Shadow220108/vex/BOM.csv

Item | Qty | Price ($) | Vendor
PCBA (2 boards) | 1 | 35.70 | JLCPCB
Total |  | 35.70
