Shadow220108/vex/production/bom.csv

Designator | Footprint | Quantity | Value | LCSC Part #
C1, C15, C16 | 1210 | 3 | 100uF
C10, C11, C14, C4, C6, C7, C8 | 0603 | 7 | 100nF
C12, C13 | 0603 | 2 | 18pF
C17, C18, C19, C20, C21, C22, C23 | 1206 | 7 | 47uF
C2, C3, C5, C9 | 0805 | 4 | 10uF
D1 | D_SMA | 1 | SMAJ5.0A
D2 | 0603 | 1 | Power-Blue
D3 | 0603 | 1 | Hub-Active Red
F1 | 1812 | 1 | 2A hold (1812)
F2 | 1812 | 1 | 1.5A hold (1812)
J1, J2, J3, J4 | USB_C_Receptacle_HRO_TYPE-C-31-M-12 | 4 | USB_C_Receptacle_USB2.0_16P
J5, J6, J7, J8 | USB_A_Molex_67643_Horizontal | 4 | USB_A
Q1, Q2, Q3 | SOT-23 | 3 | AO3401A
R1, R2 | 0603 | 2 | 5.1K
R10, R11, R12, R13, R14, R15 | 0603 | 6 | 56K
R3, R8 | 0603 | 2 | 1K
R4, R5 | 0603 | 2 | 100K
R6 | 0603 | 1 | 2.7K 1%
R7, R9 | 0603 | 2 | 10K
U1 | LQFP-48_L7.0-W7.0-P0.50-LS9.0-BL | 1 | FE2.1 | C39693
Y1 | Crystal_SMD_3225-4Pin_3.2x2.5mm | 1 | 12MHz
