Shadow220108/vex/docs/vex_zine.pdf

## I N T R O D U C I N G

# VEX

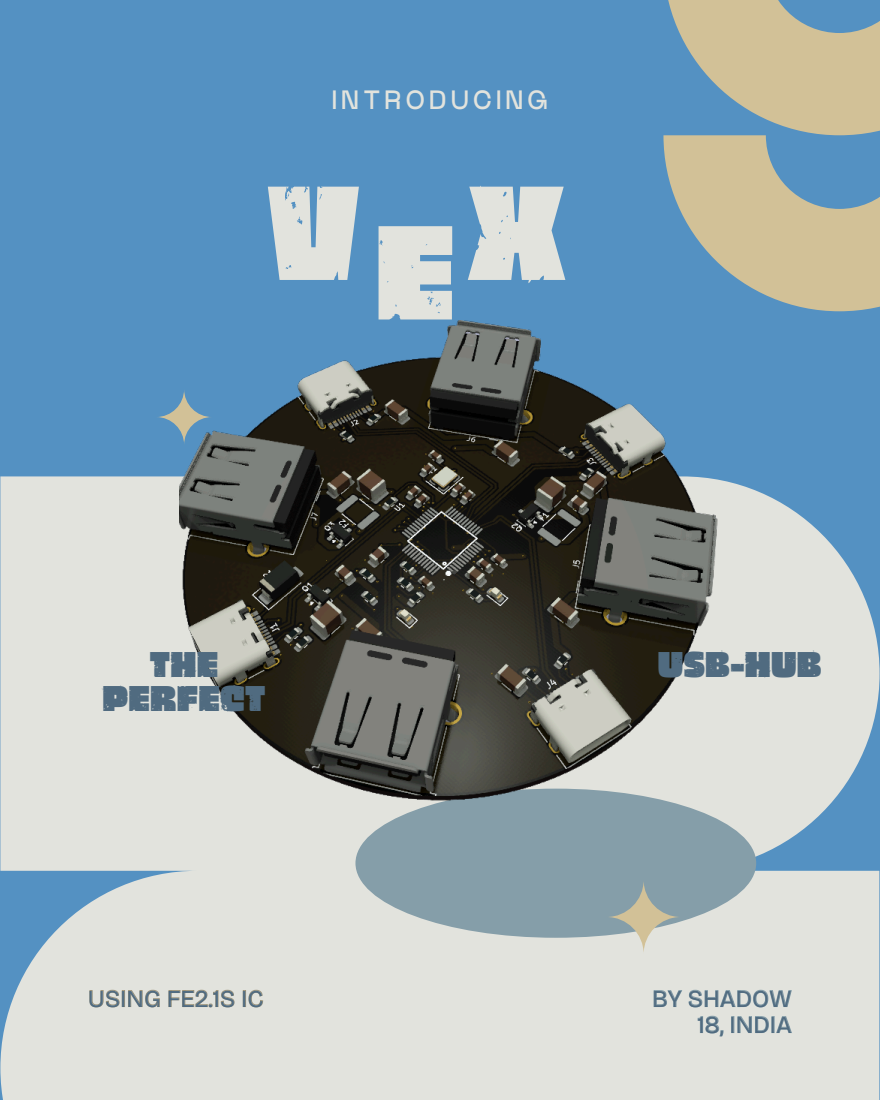
[picture p19: page 1]
THE PERFECT; USB-HUB; BY SHADOW 18, INDIA; USING FE2.1S IC
