Shadow220108/vex/PCB/vex.kicad_pcb

## KiCad design PCB/vex.kicad_pcb (2026-11-12)

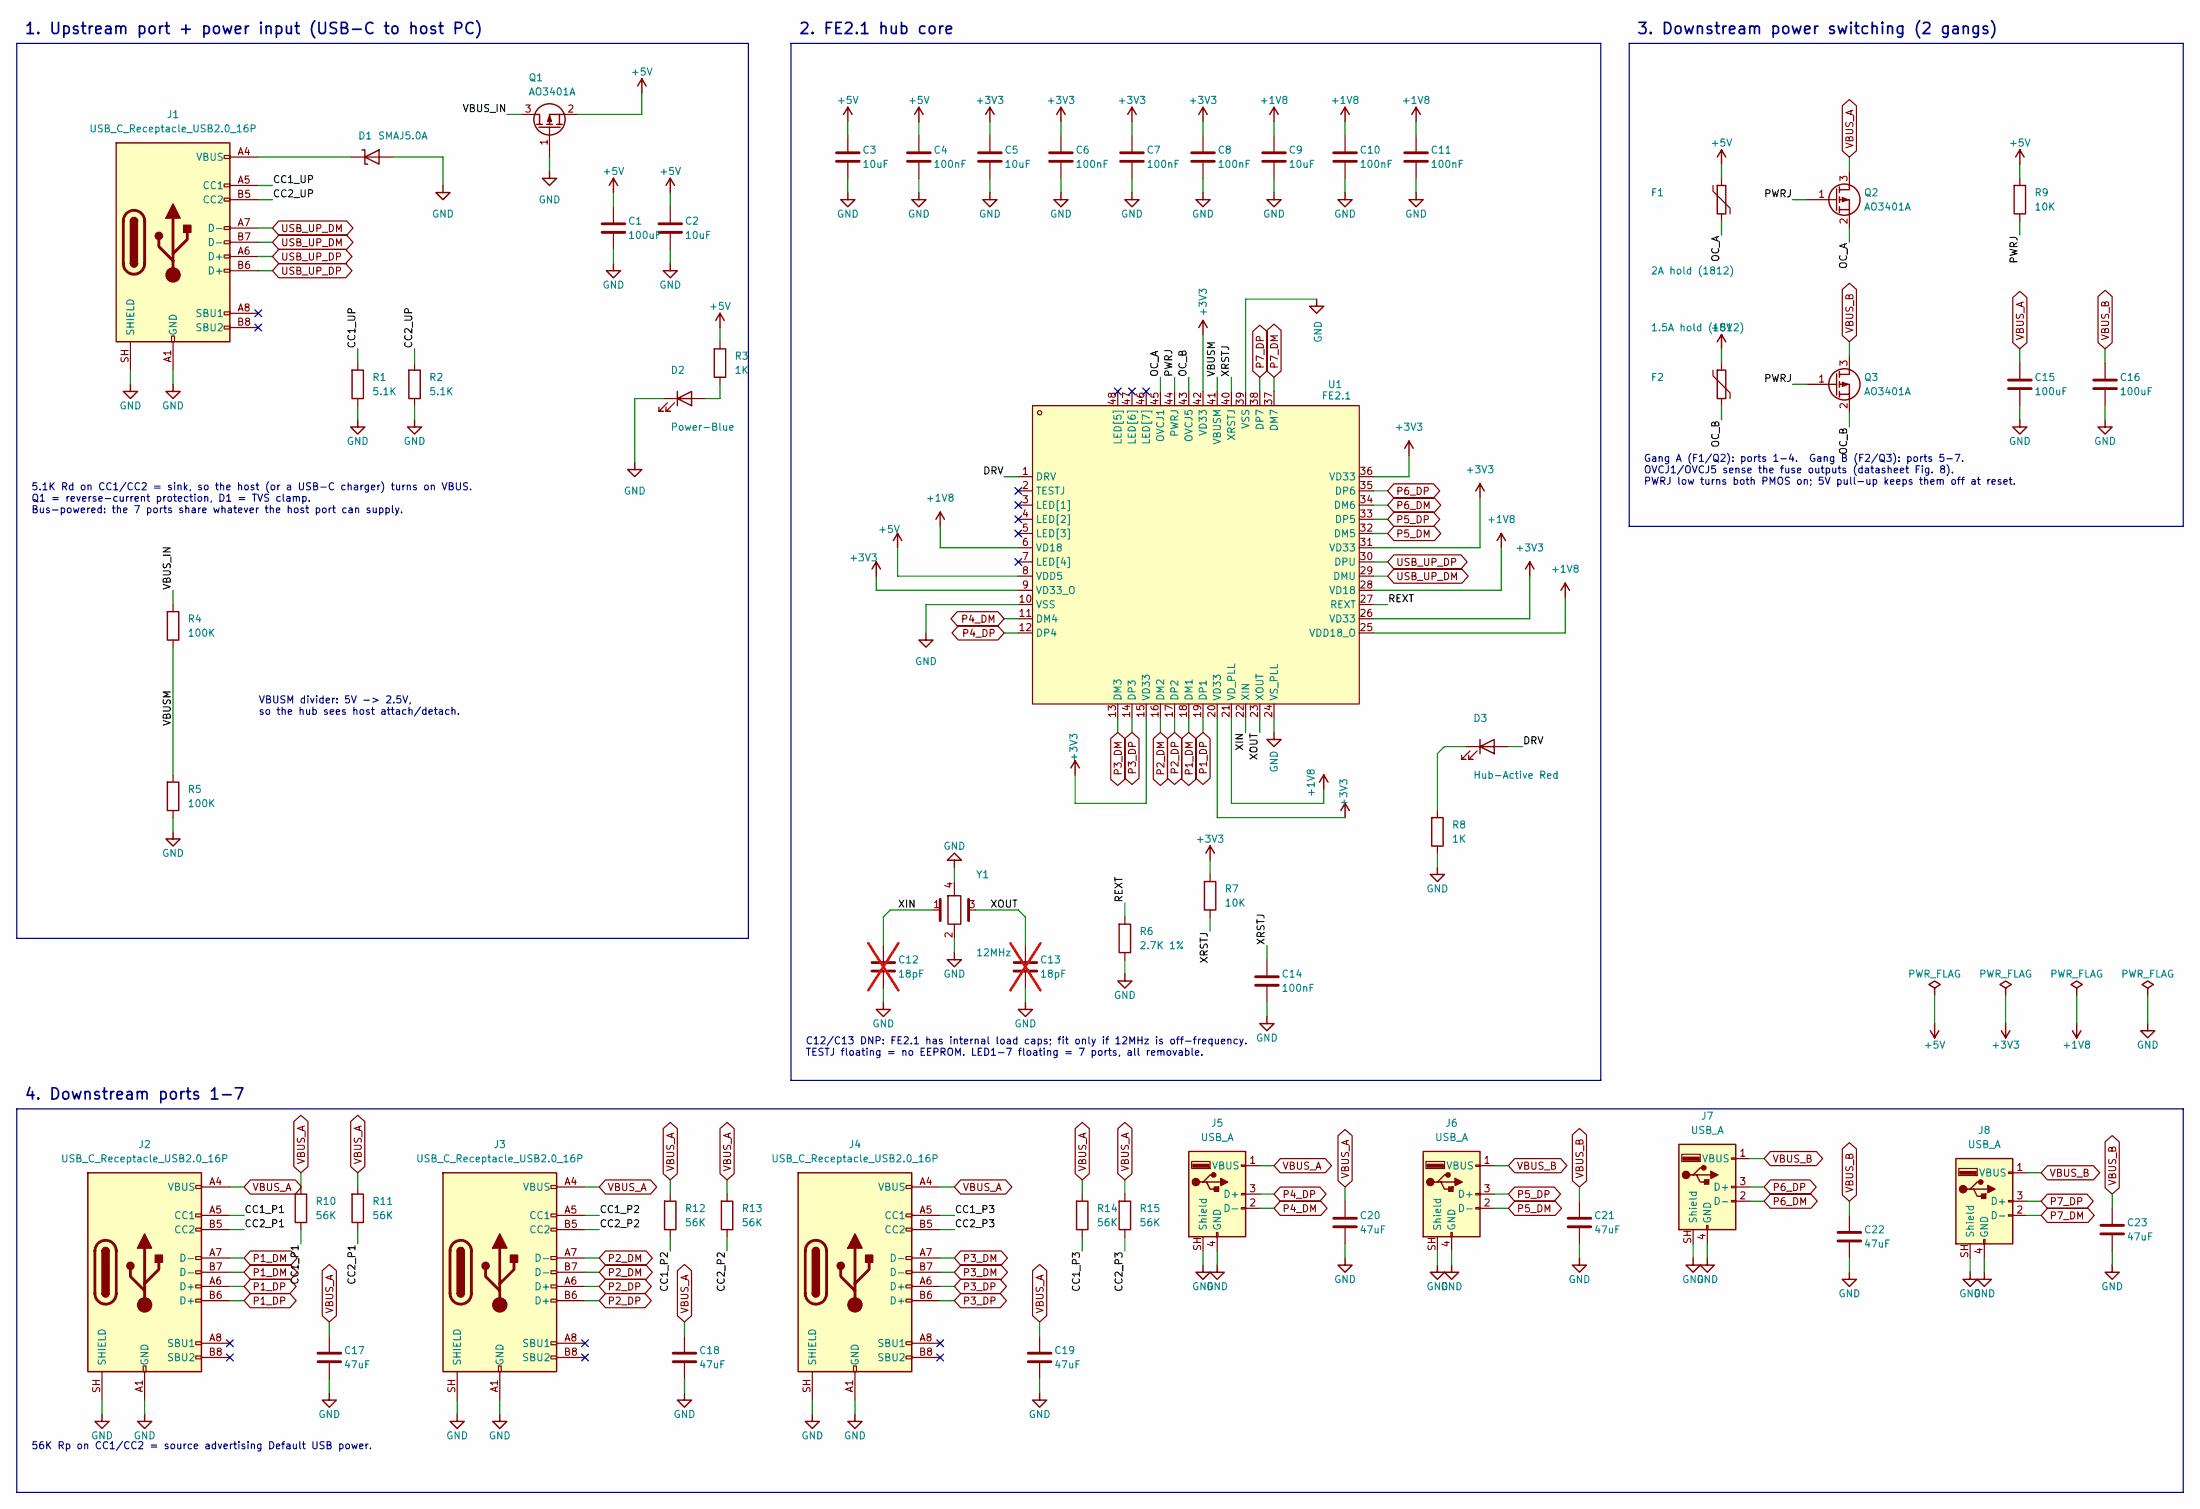
[picture p20: schematic vex.kicad_sch]

Parts:
C1, C15, C16: 100uF; C_1210_3225Metric
C2, C3, C5, C9: 10uF; C_0805_2012Metric
C4, C6, C7, C8, C10, C11, C14: 100nF; C_0603_1608Metric
C12, C13: 18pF; C_0603_1608Metric; not fitted
C17, C18, C19, C20, C21, C22, C23: 47uF; C_1206_3216Metric
D1: SMAJ5.0A; D_SMA
D2: Power-Blue; LED_0603_1608Metric
D3: Hub-Active Red; LED_0603_1608Metric
F1: 2A hold (1812); Fuse_1812_4532Metric
F2: 1.5A hold (1812); Fuse_1812_4532Metric
J1, J2, J3, J4: USB_C_Receptacle_USB2.0_16P; USB_C_Receptacle_HRO_TYPE-C-31-M-12
J5, J6, J7, J8: USB_A; USB_A_Molex_67643_Horizontal
Q1, Q2, Q3: AO3401A; SOT-23
R1, R2: 5.1K; R_0603_1608Metric
R3, R8: 1K; R_0603_1608Metric
R4, R5: 100K; R_0603_1608Metric
R6: 2.7K 1%; R_0603_1608Metric
R7, R9: 10K; R_0603_1608Metric
R10, R11, R12, R13, R14, R15: 56K; R_0603_1608Metric
U1: FE2.1; LQFP-48_L7.0-W7.0-P0.50-LS9.0-BL; MPN FE2.1-CQFP48A; LCSC Part C39693
Y1: 12MHz; Crystal_SMD_3225-4Pin_3.2x2.5mm

Connections:
+1V8: C9.1, C10.1, C11.1, U1.6 (VD18), U1.21 (VD_PLL), U1.25 (VDD18_O), U1.28 (VD18)
+3V3: C5.1, C6.1, C7.1, C8.1, R7.1, U1.9 (VD33_O), U1.15 (VD33), U1.20 (VD33), U1.26 (VD33), U1.31 (VD33), U1.36 (VD33), U1.42 (VD33)
+5V: C1.1, C2.1, C3.1, C4.1, F1.1, F2.1, Q1.2 (S), R3.1, R9.1, U1.8 (VDD5)
/CC1_P1: J2.A5 (CC1), R10.2
/CC1_P2: J3.A5 (CC1), R12.2
/CC1_P3: J4.A5 (CC1), R14.2
/CC1_UP: J1.A5 (CC1), R1.1
/CC2_P1: J2.B5 (CC2), R11.2
/CC2_P2: J3.B5 (CC2), R13.2
/CC2_P3: J4.B5 (CC2), R15.2
/CC2_UP: J1.B5 (CC2), R2.1
/DRV: D3.2 (A), U1.1 (DRV)
/OC_A: F1.2, Q2.2 (S), U1.45 (OVCJ1)
/OC_B: F2.2, Q3.2 (S), U1.43 (OVCJ5)
/PWRJ: Q2.1 (G), Q3.1 (G), R9.2, U1.44 (PWRJ)
/REXT: R6.1, U1.27 (REXT)
/VBUSM: R4.2, R5.1, U1.41 (VBUSM)
/VBUS_IN: Q1.3 (D), R4.1
/XIN: C12.1, U1.22 (XIN), Y1.1
/XOUT: C13.1, U1.23 (XOUT), Y1.3
/XRSTJ: C14.1, R7.2, U1.40 (XRSTJ)
GND: C1.2, C2.2, C3.2, C4.2, C5.2, C6.2, C7.2, C8.2, C9.2, C10.2, C11.2, C12.2, C13.2, C14.2, C15.2, C16.2, C17.2, C18.2, C19.2, C20.2, C21.2, C22.2, C23.2, D1.2 (A), D2.1 (K), J1.A1 (GND), J1.A12 (GND), J1.B1 (GND), J1.B12 (GND), J1.SH (SHIELD), J2.A1 (GND), J2.A12 (GND), J2.B1 (GND), J2.B12 (GND), J2.SH (SHIELD), J3.A1 (GND), J3.A12 (GND), J3.B1 (GND), J3.B12 (GND), J3.SH (SHIELD), J4.A1 (GND), J4.A12 (GND), J4.B1 (GND), J4.B12 (GND), J4.SH (SHIELD), J5.4 (GND), J5.SH (Shield), J6.4 (GND), J6.SH (Shield), J7.4 (GND), J7.SH (Shield), J8.4 (GND), J8.SH (Shield), Q1.1 (G), R1.2, R2.2, R5.2, R6.2, R8.2, U1.10 (VSS), U1.24 (VS_PLL), U1.39 (VSS), Y1.2, Y1.4
unnamed: D1.1 (K), J1.A4 (VBUS), J1.A9 (VBUS), J1.B4 (VBUS), J1.B9 (VBUS)
unnamed: D2.2 (A), R3.2
unnamed: D3.1 (K), R8.1
P1_DM: J2.A7 (D-), J2.B7 (D-), U1.18 (DM1)
P1_DP: J2.A6 (D+), J2.B6 (D+), U1.19 (DP1)
P2_DM: J3.A7 (D-), J3.B7 (D-), U1.16 (DM2)
P2_DP: J3.A6 (D+), J3.B6 (D+), U1.17 (DP2)
P3_DM: J4.A7 (D-), J4.B7 (D-), U1.13 (DM3)
P3_DP: J4.A6 (D+), J4.B6 (D+), U1.14 (DP3)
P4_DM: J5.2 (D-), U1.11 (DM4)
P4_DP: J5.3 (D+), U1.12 (DP4)
P5_DM: J6.2 (D-), U1.32 (DM5)
P5_DP: J6.3 (D+), U1.33 (DP5)
P6_DM: J7.2 (D-), U1.34 (DM6)
P6_DP: J7.3 (D+), U1.35 (DP6)
P7_DM: J8.2 (D-), U1.37 (DM7)
P7_DP: J8.3 (D+), U1.38 (DP7)
USB_UP_DM: J1.A7 (D-), J1.B7 (D-), U1.29 (DMU)
USB_UP_DP: J1.A6 (D+), J1.B6 (D+), U1.30 (DPU)
VBUS_A: C15.1, C17.1, C18.1, C19.1, C20.1, J2.A4 (VBUS), J2.A9 (VBUS), J2.B4 (VBUS), J2.B9 (VBUS), J3.A4 (VBUS), J3.A9 (VBUS), J3.B4 (VBUS), J3.B9 (VBUS), J4.A4 (VBUS), J4.A9 (VBUS), J4.B4 (VBUS), J4.B9 (VBUS), J5.1 (VBUS), Q2.3 (D), R10.1, R11.1, R12.1, R13.1, R14.1, R15.1
VBUS_B: C16.1, C21.1, C22.1, C23.1, J6.1 (VBUS), J7.1 (VBUS), J8.1 (VBUS), Q3.3 (D)

Notes on the sheet:
4. Downstream ports 1-7
C12/C13 DNP: FE2.1 has internal load caps; fit only if 12MHz is off-frequency. TESTJ floating = no EEPROM. LED1-7 floating = 7 ports, all removable.
VBUSM divider: 5V -> 2.5V, so the hub sees host attach/detach.
Gang A (F1/Q2): ports 1-4. Gang B (F2/Q3): ports 5-7. OVCJ1/OVCJ5 sense the fuse outputs (datasheet Fig. 8). PWRJ low turns both PMOS on; 5V pull-up keeps them off at reset.
1. Upstream port + power input (USB-C to host PC)
56K Rp on CC1/CC2 = source advertising Default USB power.
2. FE2.1 hub core
3. Downstream power switching (2 gangs)
5.1K Rd on CC1/CC2 = sink, so the host (or a USB-C charger) turns on VBUS. Q1 = reverse-current protection, D1 = TVS clamp. Bus-powered: the 7 ports share whatever the host port can supply.

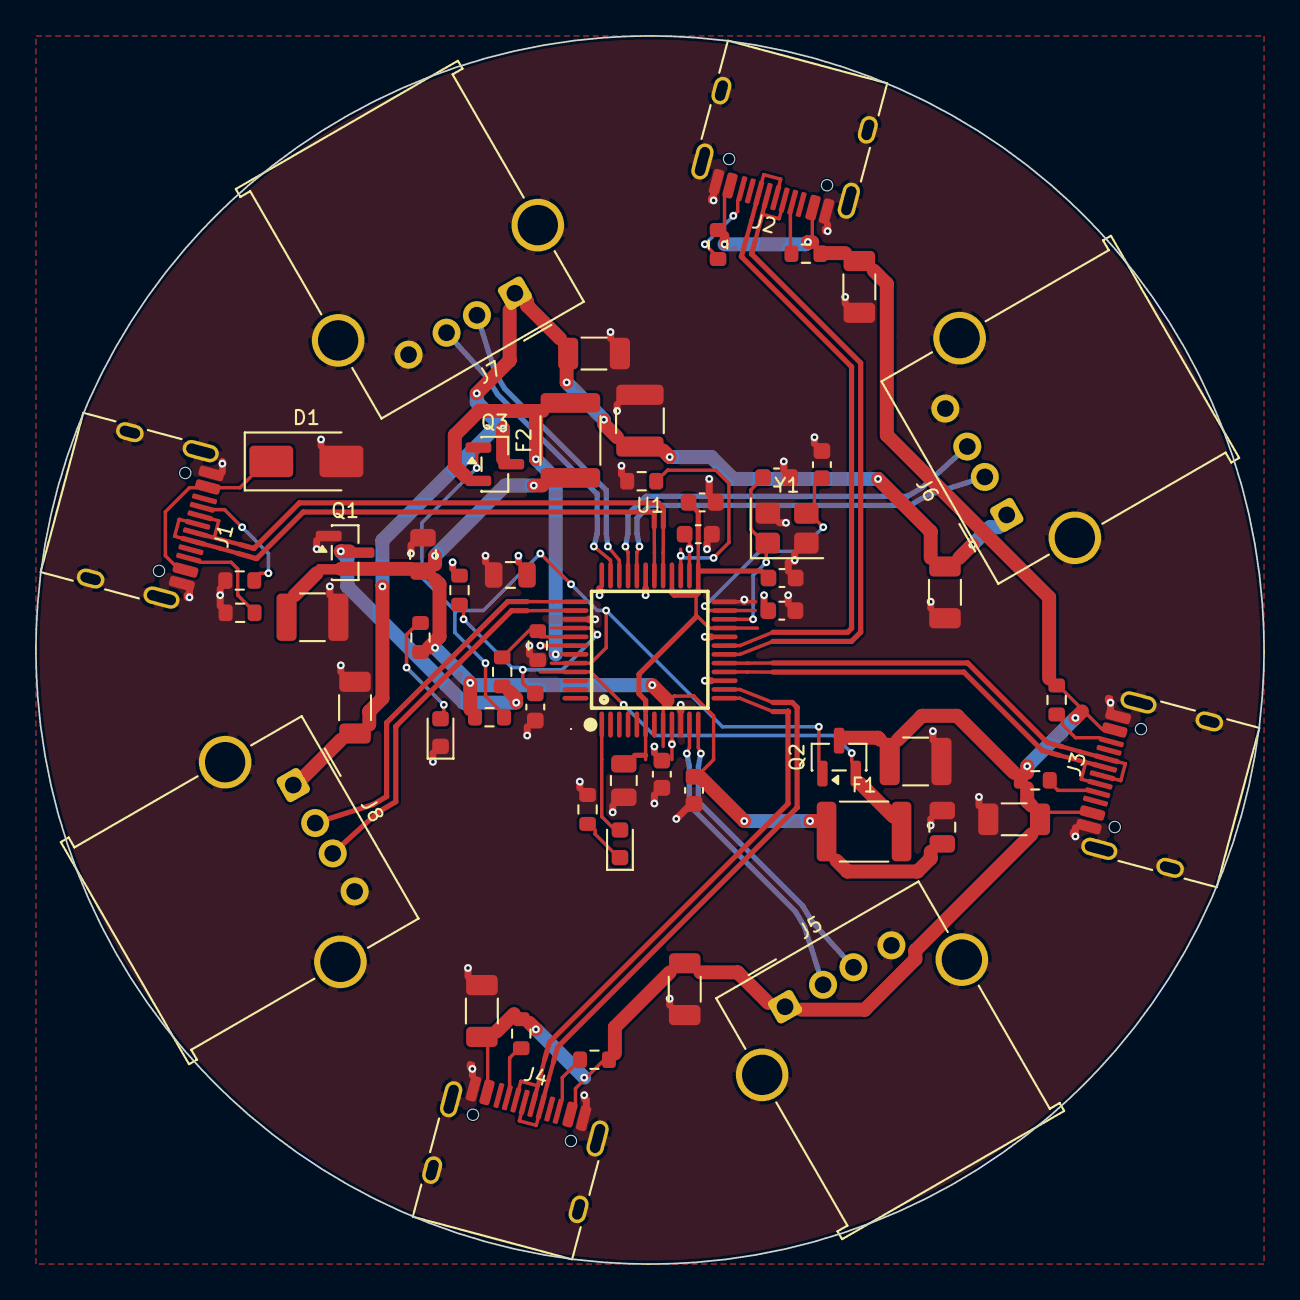
[picture p21: board vex.kicad_pcb from above]

Board: 4 copper layers, 70.0 x 70.0 mm, 56 parts (0 on the bottom side), 43 nets.
