Shadow220108/vex/(commit log)

2026-11-12 uploading all files
    [BOM.csv, bom.csv, designators.csv, positions.csv, vex.kicad_pcb, vex.kicad_sch]
2026-11-13 added bom
2026-11-13 adding price in bom
